dbuchwald/6502/Software/load/22_msbasic/os1_todo.txt

1. (DONE) Remove self-modyfying code
2. (POSTPONED) Remove dependency on custom memory segments
3. (DONE) Add Exit keyword
4. Case-insensitive comparison for tokens
5. (DONE) Disable clear at startup
6. Reduce ZP footprint (optional)
7. (DONE) Correct segment alignment
8. Fix issue with non-page aligned INPUTBUFFER
9. Make INPUTBUFFER allocation by linker
