dbuchwald/6502/(threads)

Thread 2 (2020-03-20):

Add a "ok, now what?" doc section

danecreekphotography, 2020-03-20:
Update the readme.md (or some other doc) with instructions on what to do after all the parts are soldered onto the board to verify things work correctly. Include things like:

1. How to attach the clock to the main board
2. How to use a jumper on the main board to get 1MHz clock
3. Which program to run first (04_blink_s) and second (13_4bit_lcd?)

dbuchwald, 2020-03-26:
This should be now available - can you verify and update the issue accordingly?

danecreekphotography, 2020-03-26:
Yes, this is fixed now!

Closed 2020-03-26.

Thread 3 (2020-03-20):

Add a readme for the firmware folder

danecreekphotography, 2020-03-20:
Add a readme to the firmware folder that explains what each app does, and whether they work with the current board design.

dbuchwald, 2020-04-01:
This one can be closed too, right?

danecreekphotography, 2020-04-01:
Yes!

dbuchwald, 2020-04-07:
Closing then.

Closed 2020-04-07.

Thread 5 (2020-03-20):

Add a "how to use this with Ben's stuff" document

danecreekphotography, 2020-03-20:
I suspect several people will come to this board/project while watching Ben Eater's tutorials on YouTube. The board design has variations from what Ben's doing though so nothing from Ben's tutorials will work directly.

Add documentation that explains the differences between Ben's design and this design, and provide specific steps on how to adapt Ben's code to work on this board:

1. Document the difference in address ranges, perhaps with a helpful graphic to compare the two side-by-side
2. Explain briefly why these changes were made
3. Explain how to update the locations in Ben's sample apps to ones that will work with this board

This documentation is clear enough when I can take Ben's code with updated address locations, assemble it using the assembler he uses, and have it work on this board.

dbuchwald, 2020-03-26:
This should now be covered, let me know if further changes are required

danecreekphotography, 2020-03-26:
Yes, this is fixed!

Closed 2020-03-26.

Thread 6 (2020-03-20):

Replace power on reset logic

danecreekphotography, 2020-03-20:
Instead of using the 555 timer for power on reset, use a DS1813. See https://old.reddit.com/r/beneater/comments/f9oanx/6502_power_on_reset/fitvhyv/

Thread 7 (2020-03-20):

Add a pin 1 indicator for the UART

danecreekphotography, 2020-03-20:
The silk screen on the 6502 board doesn't have an indicator for pin 1/up for the UART SMD. I had to crack open the board design in KiCad to see which one was pin 1 and make sure I put the SMD on the right way.

It'd be nice to have an indicator right on the board for which way the UART goes, just like there are for the larger ICs.

Thread 11 (2020-03-26):

Add support for WDC65C51 ACIA chip in software

dbuchwald, 2020-03-26:
Currently the software is not compatible with WDC65C51 chips due to TX-buffer-empty bug exhibited by these ICs.

dbuchwald, 2020-05-13:
Support for WDC65C51 has been implemented successfully.

Closed 2020-05-13.

Thread 15 (2020-03-26):

Redesign PCB to use smaller footprint SMD components

dbuchwald, 2020-03-26:
The whole circuitry could be largely simplified and the board size reduced if certain components are replaced by SMD counterparts

danecreekphotography, 2020-03-27:
Honestly one of the joys of using your PCB was that it *didn't* use SMD components. For noobs like me who don't have a ton of soldering experience it's way less intimidating to have a board that's all through-hole!

BestDelphini, 2020-07-20:
I learned to solder in high school and then in Navy I had to re-learn as the requirements are much different.
I have a lot solder burns from soldering in very small areas and even upside down. I have not used SMD components and like Dan I am glad there is projects that don't need it. Yes, it is smaller and even less problems with speed. I will give it a chance but don't want to. Doing things that you still understand and can have fun putting it together is what I want.

dbuchwald, 2020-07-20:
While I do understand your point about SMD components (and the fact that they are, essentially, more difficult to work with), there are certain aspects you have to take into account:

Availability of THT/PDIP components - unfortunately, when trying to use more modern chips, your options are very limited. Sometimes you can go with PLCC and THT socket for those, but more frequently than not it's not even an option,
Price factor - PCB can be made significantly smaller, when using SMD components, reducing manufacturing price. The components themselves are cheaper sometimes (not always),
SMT assembly is also significantly easier, cheaper and accessible to home user nowadays. Hot air stations of decent quality are comparable to similar soldering irons, there is plenty of material online on how to use them properly,
Last but not least - there is also my own personal "challenge" factor. I don't like doing the same thing twice the same way, I need to challenge myself, learn and develop new skills. Yes, I was intimidated at first when I saw the size of FT230XS, but I did enjoy the achievement when I managed to solder it on, and I now I have access to variety of chips not available in THT option.

The best, to be honest, would be to create two versions of the board: one that uses SMD components and one that doesn't. After schematic for version 2 is done, the project can be forked or enriched with PR. Let's see where it goes :)

BestDelphini, 2020-07-20:
I will give it a chance and I am sure I will come to the same conclusion. I have been playing with WD's W65C02SXB but was very disappointed. I was looking elsewhere when I found your project and I am willing to give it a go.

Thread 16 (2020-03-26):

Replace PS/2 port by USB connector

dbuchwald, 2020-03-26:
Assuming that the keyboard used would fall back to PS/2 compatibility mode. Will be tested first with simple PS/2->USB homemade adapter.

Thread 18 (2020-03-26):

Document Windows environment toolchain

dbuchwald, 2020-03-26:

danecreekphotography, 2020-03-27:
By far the easiest way to run this on Windows is to... not run it on Windows. Instead use WSL2 + Ubuntu from the Windows Store. Everything will build out of the box once you clone the repo with no messing around trying to get make, assemblers, etc. running on Windows.

For code editing Visual Studio Code's remote tools make it a dream. From within the Ubuntu instance you can just run VS Code and edit, save, whatever.

Flashing the ROM is done using xgpro on the Windows side. Arduino serial monitoring is also done with Arduino IDE on the Windows side.

This is how I've done every bit of building/hacking/editing with this project and it's perfect.

The only piece missing is command-line ability to transfer via xmodem. It's a minor pain, but still better than flashing the ROM every time.

dbuchwald, 2020-03-28:
For me the winning combination is Cygwin + ExtraPuTTy, but I need to document it.

Closed 2020-03-31.

Thread 19 (2020-03-26):

Test drive 8MHz clock

dbuchwald, 2020-03-26:
Currently, due to usage of R6551 chip for ACIA, clock speed is limited to 2MHz, but when WDC65C51 is supported (#11 ), it should be possible to increase up to 14MHz

dbuchwald, 2020-05-13:
Test drive completed successfully, some modifications required to LCD code. This has not been anticipated, so detailed analysis with logic probe is required for conclusive results.

dbuchwald, 2020-06-23:
8MHz operation is now fully supported.

Closed 2020-06-23.

Thread 21 (2020-03-28):

Support other layouts of LCD screen

dbuchwald, 2020-03-28:
Currently 20x4 size is assumed, but it would be great to make all the software to work correctly on 20x2.

Thread 22 (2020-03-28):

Document md5sum on MacOS

dbuchwald, 2020-03-28:
Currently it's failing on MacOS due to lack of md5sum by default - document brew install md5sha1sum

Closed 2020-03-31.

Thread 30 (2020-04-04):

Parse functions should check param length

dbuchwald, 2020-04-04:
Currently parse is successful if there are trailing characters - not correct

dbuchwald, 2020-04-05:
Resolved with latest commit

Closed 2020-04-05.

Thread 32 (2020-04-06):

Verify addresses passed to monitor

dbuchwald, 2020-04-06:
Currently this is possible to pass starting address after end address - to be corrected

Closed 2020-04-06.

Thread 34 (2020-04-07):

Incorrect value for  RV1 in BOM for clock module

Dave-TR3A, 2020-04-07:
The BOM for the clock module lists a value of 10K for RV1 (a Piher PT10-LV10-105 potentiometer).

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

That must be a typo: the Piher part number is actually for a 1M potentiometer.

With a 10K pot, the astable circuit generates a square wave with frequency between 62 and 481 Hz, which may be too fast for troubleshooting. Changing to a 1M pot yields a frequency range of 0.72 to 481 Hz.

dbuchwald, 2020-04-08:
Thanks for spotting it! I have just corrected it, can you check and let me know if it can be closed?

Dave-TR3A, 2020-04-08:
Hi Dawid:

I just looked on GitHub. Unfortunately, I’m not seeing the change you made.

Here is a screen shot from moments ago. It shows that RV1 on the BOM is
unchanged, and also shows the URL, date and time.

By the way, I changed the 10K potentiometer on the clock for a 1 M
potentiometer. Now I’m able to generate square waves with frequencies
ranging from .67Hz to 472 Hz (as measured on my oscilloscope). That’s just
what I was hoping for.

Nice job on the clock PCB!

Stay healthy.

Best wishes,

Dave MacKay

*From:* Dawid Buchwald <notifications@github.com>
*Sent:* April 8, 2020 3:25 AM
*To:* dbuchwald/6502 <6502@noreply.github.com>
*Cc:* Dave MacKay <dave@mdmackay.ca>; Author <author@noreply.github.com>
*Subject:* Re: [dbuchwald/6502] Incorrect value for RV1 in BOM for clock
module (#34)

Thanks for spotting it! I have just corrected it, can you check and let me
know if it can be closed?

—
You are receiving this because you authored the thread.
Reply to this email directly, view it on GitHub
<https://github.com/dbuchwald/6502/issues/34#issuecomment-610796642>, or
unsubscribe
<https://github.com/notifications/unsubscribe-auth/APC67OG7PRJV5STPSMBNMJLRLQREDANCNFSM4MDJ7KFA>
.

Dave-TR3A, 2020-04-08:
And now the change is showing up. Here’s a screenshot showing it:

Well done! Issue closed.

*From:* Dawid Buchwald <notifications@github.com>
*Sent:* April 8, 2020 3:25 AM
*To:* dbuchwald/6502 <6502@noreply.github.com>
*Cc:* Dave MacKay <dave@mdmackay.ca>; Author <author@noreply.github.com>
*Subject:* Re: [dbuchwald/6502] Incorrect value for RV1 in BOM for clock
module (#34)

Thanks for spotting it! I have just corrected it, can you check and let me
know if it can be closed?

—
You are receiving this because you authored the thread.
Reply to this email directly, view it on GitHub
<https://github.com/dbuchwald/6502/issues/34#issuecomment-610796642>, or
unsubscribe
<https://github.com/notifications/unsubscribe-auth/APC67OG7PRJV5STPSMBNMJLRLQREDANCNFSM4MDJ7KFA>
.

Dave-TR3A, 2020-04-08:
Clock module BOM updated to show value of RV1 as 1M ohm.

dbuchwald, 2020-04-08:
Thanks a lot, stay safe!

Closed 2020-04-08.

Thread 36 (2020-04-09):

Prevent LCD routines from altering tmp/ptr variables

dbuchwald, 2020-04-09:
Currently all the code has been changed to work around this, but it can have negative impact on future code maintainability

Closed 2020-04-09.

Thread 37 (2020-04-09):

Enable abort operation in modem receive

dbuchwald, 2020-04-09:
Currently it's not possible to abort receive operation

dbuchwald, 2020-04-18:
Fixed

Closed 2020-04-18.

Thread 38 (2020-04-10):

Add support for capslock key in keyboard controller

dbuchwald, 2020-04-10:
Currently it simply doesn't work - keypress is registered, but apparently it requires command to be sent back to keyboard to enable.
Not that it's high priority defect, but should be fixed.

Thread 39 (2020-04-11):

Add modem receive failure after long wait with no reply

dbuchwald, 2020-04-11:
Currently it waits forever, should fail after several attempts

Thread 40 (2020-04-11):

Add printable characters preview in Monitor get function

dbuchwald, 2020-04-11:
Currently only hex values are displayed, but for printable characters it would be good to print them "as is" as well

dbuchwald, 2020-04-30:
Resolved

Closed 2020-04-30.

Thread 44 (2020-04-18):

Add direct links to purchase BOM items

danecreekphotography, 2020-04-18:
Add links to Jameco and/or DigiKey for purchasing the items on the BOM.

danecreekphotography, 2020-04-18:
Working on this now.

dbuchwald, 2020-05-13:
This should be closed now, right?

danecreekphotography, 2020-05-13:
Yup!

Closed 2020-05-13.

Thread 49 (2020-05-12):

VGA video output

marcpiulachs, 2020-05-12:
Do you plan to add any kind of video output to the computer? You currently have a ATtiny4313 that is only used for the ps/2 keyboard interface that could probably also be used to generate some rudimentary VGA signal https://hackaday.com/2015/12/17/attiny-does-170x240-vga-with-8-colors/

dbuchwald, 2020-05-13:
Hey, thanks for sharing, and yes, I'm aware of the possibility to use ATtiny as VGA signal generator, but there are two issues with it at the moment:

1. Current solution doesn't provide enough video RAM for any reasonable output (keyboard buffer takes up a lot of memory on ATTiny), so I would need to share system RAM between ATTiny and 6502, and while this is perfectly doable, it requires access to certain 6502 pins that are currently "blocked" (as in: pulled up or down on PCB). This basically requires another revision of PCB and this one might actually be used for it:
https://github.com/tonylweil/6502
2. Even if I ever do any kind of VGA interface, I would rather implement that with much simpler and easier to control set of TTL chips, like the Ben's video card. That being said, I don't have that much interest in VGA signal generation, and I definitely don't want to build any kind of primitive game console. What I wanted this thing to be was educational device that demonstrates basics of computer build and OS development. Serial connection is perfectly sufficient for these purposes...

Again - at some point I might actually consider building discrete, TTL based VGA output, but mostly aimed at text mode. Graphics will be always secondary.

Thanks for showing interest in my project!

marcpiulachs, 2020-05-13:
Hi, it makes perfectly sense. Thanks for your great work with this project, it's a great tool for people like me who came from a software background with little experience on hardware that want to learn the basics of a computer and how it works but does not feel confortable with wires and breadboards, also the software is a great complement to Ben's excelent series. Please keep the great work!

dbuchwald, 2020-05-13:
Thanks for your comment; it seems that quite a lot of us share the same background in software development and this might be the first serious EE project. It is definitely the first for me :)

And this is exactly where I envisioned this project - to be soft of "no frills" intro to hardware and low level software design, building on top of Ben's introduction to 6502 and computer prototyping.

kyleeddy, 2021-08-12:
Not VGA, but definitely authentic - I've had some initial luck using the [TMS9918a board](https://github.com/jblang/TMS9918A) designed by [@jblang](https://www.github.com/jblang). Connection uses pins available on the J7 connect of your v001 board. The board is designed to work with the rc2014-style systems, but works well with some creative use of the jumpers and an added 74HCT04 for timing delays.

Alex-Kw, 2023-01-17:
> Not VGA, but definitely authentic - I've had some initial luck using the [TMS9918a board](https://github.com/jblang/TMS9918A) designed by [@jblang](https://www.github.com/jblang). Connection uses pins available on the J7 connect of your v001 board. The board is designed to work with the rc2014-style systems, but works well with some creative use of the jumpers and an added 74HCT04 for timing delays.

If we are mentioning the RC2014, there is an HDMI and Composite Pi terminal, and a VGA terminal. The latter is more relevant here and more available anyway. I have the HDMI one, and it connects to the serial bus; I have TX and RX split so that input comes from a serial device, but output goes to the video terminal. It's likely this could be adapted for many microcomputers with serial text output. https://rc2014.co.uk/modules/pi-pico-vga-terminal/

If I get a chance to try it i will report back, as I intend to obtain one for my RC2014 anyway.

Thread 50 (2020-08-03):

Unable to get ps/2 keyboard input working

jonlorusso, 2020-08-03:
I've flashed my ATTiny4313 with the keyboard_4313 sketch, using an Arduino as ISP:

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

I also flashed the rom with`Software/rom/19_keyboard_test`.

When I boot the computer (with a ps2 keyboard plugged in) the lights briefly flash on the keyboard.

It then shows key `4` as being pressed intermittently, but I am unable to type anything.

I checked my solder joints on the ps/2 connector, and they look ok.

dbuchwald, 2020-08-03:
Hey, thanks for reporting this, but I would need more information about the problem:

1. What kind of keyboard are you using (native PS/2 or via connector),
2. How did you flash the ATTiny4313 (I need details on which pin was connected to which pin on the AVR ISP interface),
3. Are you absolutely sure that the keyboard is working fine?

When I get these details I will repeat the same process (including the ATTiny upload) exactly as you did, but with logic analyser connected to the ATTiny pins to see what happens there. Basically this should work "just like that", I have never seen any issues on my build and I know of other builds where it also worked fine. This might be problem with solder joints on the ATTiny or VIA socket. You can do simple continuity tests on ATTiny pins and respective VIA connectors, but let's start with me repeating your procedure.

jonlorusso, 2020-08-03:
1. What kind of keyboard are you using (native PS/2 or via connector),

PS/2 keyboard

2. How did you flash the ATTiny4313 (I need details on which pin was connected to which pin on the AVR ISP interface),

I used an Arduino UNO as ISP (ArduinoISP sketch).  I then connected the Arduino UNO to the 6502 ICSP interface:

5V -> 5V
GND -> GND
Pin 10 -> RESET
Pin 11 -> MOSI
Pin 12 -> MISO
Pin 13 -> SCK

In the Arduino interface I selected "Arduino as ISP", ATTiny4313 as board/chip, and 8 MHz for speed.

3. Are you absolutely sure that the keyboard is working fine?

To be completely honest, I don't know.  I purchased the keyboard specifically for this purpose, so it's brand new, but obviously could be defective.

Thanks!

jonlorusso, 2020-08-03:
> You can do simple continuity tests on ATTiny pins and respective VIA connectors, but let's start with me repeating your procedure.

For what it's worth, everything appears to be wired up correctly (after continuity tests on all the ATTiny pins).

jonlorusso, 2020-08-03:
One additional piece of information (perhaps useless):

The keyboard lights flash again once (briefly) while the text "Keyboard testing program. is displayed on the LCD, but prior to the "Key pressed: 4" and "Key pressed [ENTER]"

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

dbuchwald, 2020-08-04:
Hey, sorry, I have tried to replicate the issue you are observing, but it still works on my build. These are the steps I took:

1. Checked out master branch
2. Uploaded rom/19_keyboard_test to EEPROM
3. Uploaded keyboard_4313 using Arduino as ISP programmer (the only difference - used Arduino Mega instead of Uno, as I don't own one)
4. Inserted 1MHz oscillator for system clock
5. Connected PS/2 keyboard
6. Run the computer

It detected keyboard correctly and worked fine displaying keys that I pressed.

So, current version of the code should work correctly with the PCB and working keyboard. These are the possible issues that could cause it:

- Incorrect seating of ATTiny4313 or VIA chip
- Failed upload (I actually had to struggle for a bit to upload the sketch, it didn't work immediately, USBasp is much more stable)
- Soldering issue
- Broken keyboard
- Last but not least - I don't even know if this is possible, but maybe the PS/2 connector you use doesn't match the pinout assumed in PCB design?

I would advise using one of these cheap logic analysers (13$ or so) to confirm that the signal coming to ATTiny is correct. You need to connect two lines to pins 2 and 6 - these are DAT/CLK of PS/2 respectively. If this is correct (represents keys pressed on keyboard), then check ATTiny output on pins 12-19 to confirm that correct data is transmitted to VIA.

Sorry I can't help you any further, but it "just works" on my build...

dbuchwald, 2020-08-05:
One last thing - it's actually possible that the fuses on your ATTiny are incorrectly set. Arduino IDE doesn't burn them with the sketch, you need to "Burn Bootloader" first, even if you don't intend to use the bootloader (which, by the way, is not even possible for ATTiny4313). Try this and let me know if it helps, please.

jonlorusso, 2020-08-05:
> you need to "Burn Bootloader" first, even if you don't intend to use the bootloader

🤦‍♂️🤦‍♂️🤦‍♂️

That was it!  Keyboard is now working! Thanks!

dbuchwald, 2020-08-05:
Awesome, I'm glad we managed to find the reason! I will update the documentation to reflect this step.

dbuchwald, 2020-08-05:
Documentation updated

Closed 2020-08-05.

Thread 51 (2020-09-27):

Please provide PDFs for schematic

marcin-chwedczuk, 2020-09-27:
Currently you cannot take a look at the schematic using build-in GitHub file preview.
Could you add schematics in PDF format, please? (can be done using File -> Plot... in KiCad).

Schematics would also be much easier to read if they where stored into a single directory as a hierarchical sheet. Then you can have one PDF with hierarchy on the first page and all the schematics on the following pages.

marcin-chwedczuk, 2020-09-28:
Ouch - I didn't notice them. Yeah they are there not that you pointed it out. Thanks.

Closed 2020-09-28.

Thread 53 (2021-08-23):

help compiling .c files

mattmi91, 2021-08-23:
I am unsure how to compile the .c files in the 6502 projects ROM folder im not sure what to use crygwin? cc65? and what commands do I type into these to compile the .C file into an .out file ive been looking on the internet for days and cannot find anything Im looking for so some pointers on how to do this would be nice :)

rprouse, 2021-08-23:
Every project has a `Makefile`, so running `make clean all` should do it for you. It does use cc65, so that needs to be in your path as does GNU Make. I found that Dawid's makefiles don't work well under Windows, so he uses Cygwin.

Instructions to get setup are here, https://github.com/dbuchwald/6502/blob/master/Software/README.md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

mattmi91, 2021-08-23:
I have tried using cygwin and I did install all the packages he said too but not sure what to type to make the .out file? he doesnt how other then just basics on what to do when you first install it which I already did but what do I type in the terminal something like g++ lcdtest.c? tried this and got like 50 errors

rprouse, 2021-08-23:
Did you try typing `make clean all`?

mattmi91, 2021-08-23:
I get this when I type that make: *** No rule to make target 'clean'.  Stop.

mattmi91, 2021-08-23:
ok so I fixed the make file issue but when I do g++ 4bitlcd.s
$ g++ 4bitlcd.s
4bitlcd.s: Assembler messages:
4bitlcd.s: Warning: end of file not at end of a line; newline inserted
4bitlcd.s:1: Error: unknown pseudo-op: `.setcpu'
4bitlcd.s:2: Error: can't open lcd.inc for reading: No such file or directory
4bitlcd.s:3: Error: unknown pseudo-op: `.segment'
4bitlcd.s:9: Error: unknown pseudo-op: `.code'
4bitlcd.s:12: Error: no such instruction: `jsr _lcd_init'
4bitlcd.s:14: Error: no such instruction: `write_lcd '
4bitlcd.s:16: Error: no such instruction: `ldx '
4bitlcd.s:18: Error: no such instruction: `lda chars_msg,x'
4bitlcd.s:19: Error: no such instruction: `beq end_loop'
4bitlcd.s:20: Error: no such instruction: `jsr _lcd_print_char'
4bitlcd.s:21: Error: no such instruction: `inx '
4bitlcd.s:22: Error: no such instruction: `bra char_loop'
4bitlcd.s:24: Error: no such instruction: `bra end_loop'
4bitlcd.s:26: Error: unknown pseudo-op: `.segment'

rprouse, 2021-08-24:
`make` builds all the files, you don't call `g++`. The file that you are trying to compile is assembly language, not C++, so it is assembled by `cc65`, but you don't have to call that either, `make all` does that for you and puts the output in a build or bin folder.

Just switch to the `Software` directory and type `make clean all`. That's it, nothing more, it will build everything.

rprouse, 2021-08-24:
I should add that you can't build most of the individual files in this repo and get a runnable program. Almost all of them include files in the `common` directory, that is why you need the `Makefile`, to coordinate the building and linking of all the files.

mattmi91, 2021-08-24:
so im in the directory of where that c file is and when I type make all I get already a directory message

mattmi91, 2021-08-24:
im just trying to get the a.out file from these so I can program it into my eeprom

rprouse, 2021-08-24:
As I said,

> Just switch to the Software directory and type make clean all. That's it, nothing more, it will build everything.

Then look in the `build` folder that is created.

mattmi91, 2021-08-24:
did what you said and here is the error that I got
$ make clean all
rm -rf build
make -C rom/01_nop_fill ADDRESS_MODE=ext all
make[1]: Entering directory '/home/matthew/6502-master/software/rom/01_nop_fill'
ca65 --cpu 65C02 -Dclock_mode_flag=2  -Dacia_tx_irq=0  -Ddb6502 -I ../../common/include -o ../../build/common/zeropage.o -l ../../build/common/zeropage.lst ../../common/source/zeropage.s
make[1]: ca65: No such file or directory
make[1]: *** [../../common/makefile:184: ../../build/common/zeropage.o] Error 127
make[1]: Leaving directory '/home/matthew/6502-master/software/rom/01_nop_fill'
make: *** [makefile:76: build/rom/01_nop_fill.ext.bin] Error 2

mattmi91, 2021-08-24:
tried under the first clean all test he mentions in the rom folder
$ make clean all
rm -f ../../build/rom/*.bin \
rm -f ../../build/rom/*.raw \
../../build/rom/01_nop_fill/*.o \
../../build/rom/01_nop_fill/*.lst \
../../build/rom/01_nop_fill/*.s \
../../build/rom/01_nop_fill/*.map \
../../build/common/*.o \
../../build/common/*.lst \
../../build/common/*.s \
../../build/lib/*.lib
ca65 --cpu 65C02 -Dclock_mode_flag=2  -Dacia_tx_irq=0  -Ddb6502 -I ../../common/include -o ../../build/common/zeropage.o -l ../../build/common/zeropage.lst ../../common/source/zeropage.s
make: ca65: No such file or directory
make: *** [../../common/makefile:184: ../../build/common/zeropage.o] Error 127

rprouse, 2021-08-24:
1. `make clean` fails if you have not built before and the build directory does not exist. In that case `make all` will do.
2. To solve your error `ca65` needs to be added to your path. Google how to do that in Cygwin, I think you add it to your `.bashrc` file but I don't use Cygwin. If you can type `ca65` at the command line without errors, then `make` will work.

mattmi91, 2021-08-24:
tried adding the path in my system variables
C:\cygwin64\home\matthew\6502-master\Software\ca65
of course did not work -_- this is why I hate dealing with software so irritating lol

rprouse, 2021-08-24:
If you are using cygwin, that isn't a correct Linux path. Try `~/home/matthew/6502-master/Software/ca65`

mattmi91, 2021-08-24:
im using cygwin on windows 10

mattmi91, 2021-08-24:
ok I solved the problem but im not getting a bin file that I need like he describes
$ make clean all
rm -f ../../build/rom/*.bin \
rm -f ../../build/rom/*.raw \
../../build/rom/01_nop_fill/*.o \
../../build/rom/01_nop_fill/*.lst \
../../build/rom/01_nop_fill/*.s \
../../build/rom/01_nop_fill/*.map \
../../build/common/*.o \
../../build/common/*.lst \
../../build/common/*.s \
../../build/lib/*.lib
ca65 --cpu 65C02 -Dclock_mode_flag=2  -Dacia_tx_irq=0  -Ddb6502 -I ../../common/include -o ../../build/common/zeropage.o -l ../../build/common/zeropage.lst ../../common/source/zeropage.s
ca65 --cpu 65C02 -Dclock_mode_flag=2  -Dacia_tx_irq=0  -Ddb6502 -I ../../common/include -o ../../build/common/sysram_map.o -l ../../build/common/sysram_map.lst ../../common/source/sysram_map.s
ca65 --cpu 65C02 -Dclock_mode_flag=2  -Dacia_tx_irq=0  -Ddb6502 -I ../../common/include -o ../../build/rom/01_nop_fill/nop_fill.o -l ../../build/rom/01_nop_fill/nop_fill.lst nop_fill.s
ca65 --cpu 65C02 -Dclock_mode_flag=2  -Dacia_tx_irq=0  -Ddb6502 -I ../../common/include -o ../../build/common/syscalls.o -l ../../build/common/syscalls.lst ../../common/source/syscalls.s
ca65 --cpu 65C02 -Dclock_mode_flag=2  -Dacia_tx_irq=0  -Ddb6502 -I ../../common/include -o ../../build/common/acia.o -l ../../build/common/acia.lst ../../common/source/acia.s
ca65 --cpu 65C02 -Dclock_mode_flag=2  -Dacia_tx_irq=0  -Ddb6502 -I ../../common/include -o ../../build/common/blink.o -l ../../build/common/blink.lst ../../common/source/blink.s
ca65 --cpu 65C02 -Dclock_mode_flag=2  -Dacia_tx_irq=0  -Ddb6502 -I ../../common/include -o ../../build/common/core.o -l ../../build/common/core.lst ../../common/source/core.s
ca65 --cpu 65C02 -Dclock_mode_flag=2  -Dacia_tx_irq=0  -Ddb6502 -I ../../common/include -o ../../build/common/keyboard.o -l ../../build/common/keyboard.lst ../../common/source/keyboard.s
ca65 --cpu 65C02 -Dclock_mode_flag=2  -Dacia_tx_irq=0  -Ddb6502 -I ../../common/include -o ../../build/common/lcd.o -l ../../build/common/lcd.lst ../../common/source/lcd.s
ca65 --cpu 65C02 -Dclock_mode_flag=2  -Dacia_tx_irq=0  -Ddb6502 -I ../../common/include -o ../../build/common/lcd4bit.o -l ../../build/common/lcd4bit.lst ../../common/source/lcd4bit.s
ca65 --cpu 65C02 -Dclock_mode_flag=2  -Dacia_tx_irq=0  -Ddb6502 -I ../../common/include -o ../../build/common/modem.o -l ../../build/common/modem.lst ../../common/source/modem.s
ca65 --cpu 65C02 -Dclock_mode_flag=2  -Dacia_tx_irq=0  -Ddb6502 -I ../../common/include -o ../../build/common/string.o -l ../../build/common/string.lst ../../common/source/string.s
ca65 --cpu 65C02 -Dclock_mode_flag=2  -Dacia_tx_irq=0  -Ddb6502 -I ../../common/include -o ../../build/common/utils.o -l ../../build/common/utils.lst ../../common/source/utils.s
ca65 --cpu 65C02 -Dclock_mode_flag=2  -Dacia_tx_irq=0  -Ddb6502 -I ../../common/include -o ../../build/common/via.o -l ../../build/common/via.lst ../../common/source/via.s
ca65 --cpu 65C02 -Dclock_mode_flag=2  -Dacia_tx_irq=0  -Ddb6502 -I ../../common/include -o ../../build/common/via_utils.o -l ../../build/common/via_utils.lst ../../common/source/via_utils.s
ca65 --cpu 65C02 -Dclock_mode_flag=2  -Dacia_tx_irq=0  -Ddb6502 -I ../../common/include -o ../../build/common/tty.o -l ../../build/common/tty.lst ../../common/source/tty.s
ca65 --cpu 65C02 -Dclock_mode_flag=2  -Dacia_tx_irq=0  -Ddb6502 -I ../../common/include -o ../../build/common/parse.o -l ../../build/common/parse.lst ../../common/source/parse.s
ca65 --cpu 65C02 -Dclock_mode_flag=2  -Dacia_tx_irq=0  -Ddb6502 -I ../../common/include -o ../../build/common/menu.o -l ../../build/common/menu.lst ../../common/source/menu.s
ar65 r ../../build/lib/common.lib ../../build/common/syscalls.o ../../build/common/acia.o ../../build/common/blink.o ../../build/common/core.o ../../build/common/keyboard.o ../../build/common/lcd.o ../../build/common/lcd4bit.o ../../build/common/modem.o ../../build/common/string.o ../../build/common/utils.o ../../build/common/via.o ../../build/common/via_utils.o ../../build/common/tty.o ../../build/common/parse.o ../../build/common/menu.o
ca65 --cpu 65C02 -Dclock_mode_flag=2  -Dacia_tx_irq=0  -Ddb6502 -I ../../common/include -o ../../build/common/crt0.o -l ../../build/common/crt0.lst ../../common/source/crt0.s
cp -f ../../common/none.lib ../../build/lib/common.c.lib
ar65 r ../../build/lib/common.c.lib ../../build/common/crt0.o
ld65  -C ../../common/firmware.ext.cfg -m ../../build/rom/01_nop_fill/01_nop_fill.ext.map -o ../../build/rom/01_nop_fill.ext.bin ../../build/common/zeropage.o ../../build/common/sysram_map.o ../../build/rom/01_nop_fill/nop_fill.o ../../build/lib/common.lib ../../build/lib/common.c.lib

rprouse, 2021-08-24:
did you look in the folders under build/roms? I saw them being created in the output you sent.

mattmi91, 2021-08-24:
thanks for the help with the advice of getting that make clean all command, the fix was I had to put cc65 exe files inside the cygwin64 folder then it worked it was a lucky guess but I got it :)

rprouse, 2021-08-24:
Excellent, happy 8-bit computing. Can you close this issue? Only you or @dbuchwald can.

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

mattmi91, 2021-08-24:
maybe it would help someone else that has similar problem?

rprouse, 2021-08-24:
It may help someone else, but they will still be able to find it in search. It is normal in GitHub to close issues that are resolved or the questions answered.

Thread 56 (2022-07-15):

Dead?

Phunter1, 2022-07-15:
Seems everything dropped off 2 years ago. Is this project dead? I would rather not put time into something that is dead.

Kevin-smurf, 2022-07-15:
Hi Phunter1,  I built dbuchwald's project a couple of years ago, after watching Ben Eaters excellent tutorials on YouTube.
I firstly built Bens 6502 breadboard project after sourcing all the components myself.
Then I found Mr Buchwald's PCB version, and built that too.  I'm not a programming buff, so got a bit lost, but finally got it working.  I learnt heaps from doing this.
It's been on the "back burner" since then !!!

dbuchwald, 2022-07-15:
Hey, the project is not dead, but indeed, it has been hibernating for last two years. I started redesign of the board, but scope creep and too ambitious goals prevented me from reaching next milestone. Seeing how it blocked my progress I went back to drawing board, decided to split the project in smaller chunks and one of the prerequisites was using latest line of AVR microprocessors with different programming interface.
Long story short, I went to implement the new interface in avrdude project and spent there next six months. Changed jobs in the meantime and, well, life simply happened. The fact that there are other better designs out there doesn't help either, but the main reason for putting that aside was simply lack of interest from the community. Most of these projects end up like that, because we learn from each other and the most persistent prevail. People would rather design their own build, and use others as an inspiration/guideline.

As for putting time into something that is dead, I'm not entirely sure you mean. The PCB has been built by many people, and as far as I know, each of these builds is running fine. Software is usable, and there is enough of it to use it to start building your own applications. So yeah, it's not like you will spend weeks building it and figuring out compilation options - it will simply build, load and run, and if you use PCB you are almost guaranteed to have the thing running in a week.
If you have any issues, you can always contact me here or drop me an e-mail.

Phunter1, 2022-07-15:
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

This is the first time I've gotten into projects like this so I may be looking at it in the wrong light.

Nice to know it's not forgotten.

I'll be building this project shortly.

Closed 2022-07-15.

Thread 58 (2025-01-03):

replacement for  FB1 Ferrite bead small

bobhillierca, 2025-01-03:
I can't locate a source for FB1 small Ferrite bead.  Digikey shows them no longer available and I can't find them on the Jameco site.  I have tried to puzzle through the characteristics to select an equivalent but have ended up ordering two unsuitable components. Can someone recommend an alternative component that can fit and/or barnacle to the pcb?

rprouse, 2025-01-06:
I had trouble sourcing one too. I used this and haven't had an issue, https://www.digikey.ca/en/products/detail/toshiba-semiconductor-and-storage/LB4X2X8U/4701156
