dbuchwald/6502/Schematics/65C02_Computer/65C02_Computer.pdf

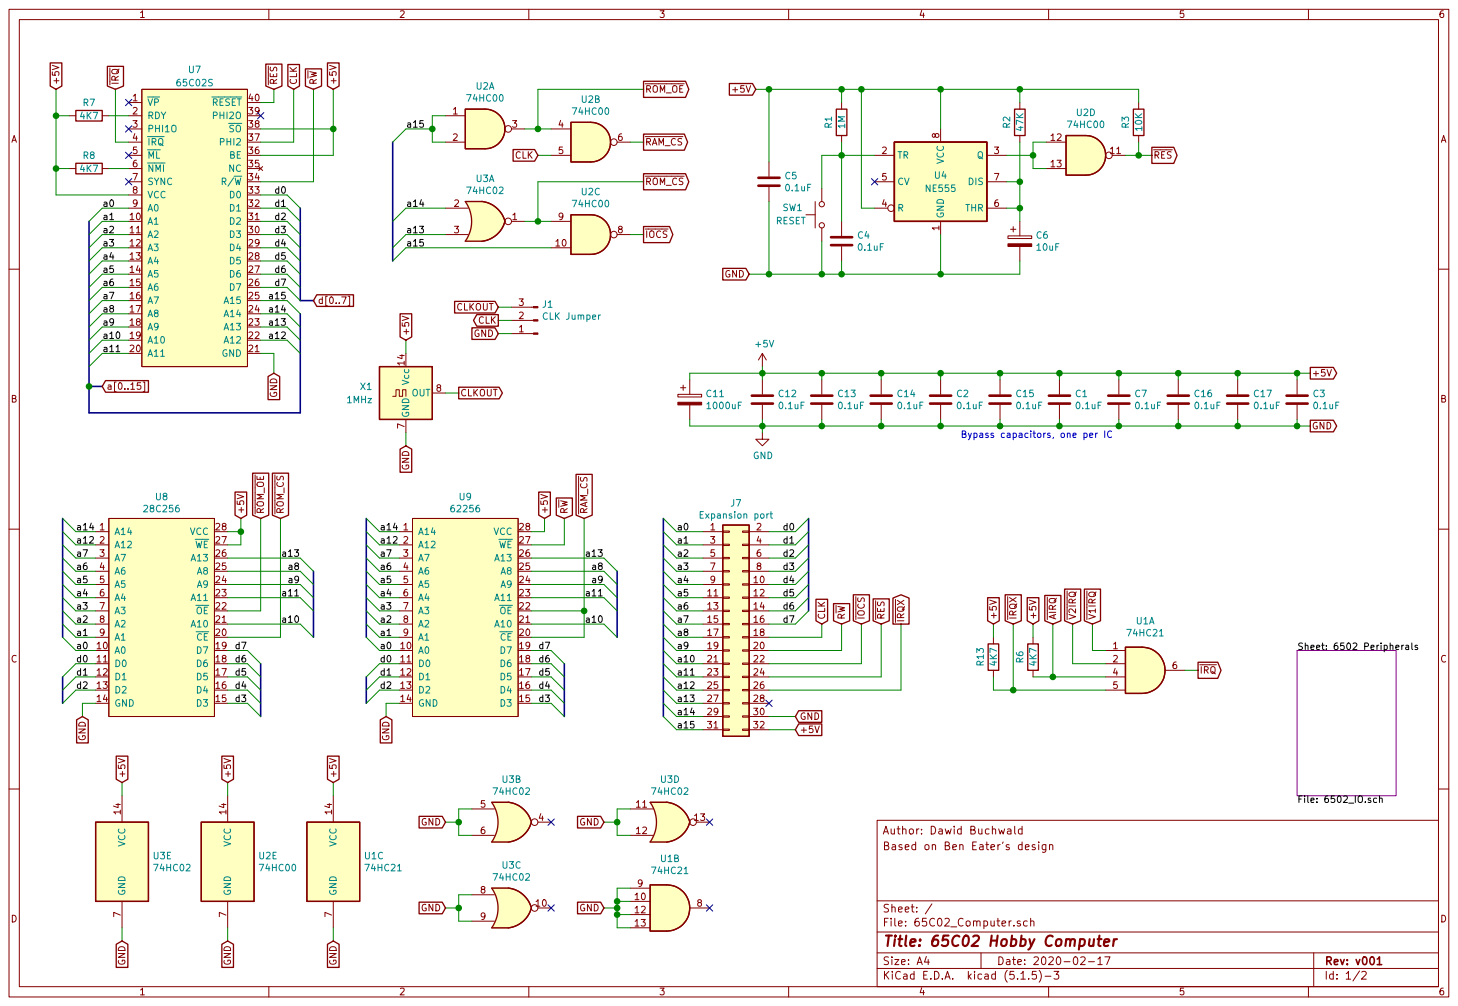
[picture p1: page 1]

Id: 1/2 Title: 65C02 Hobby Computer

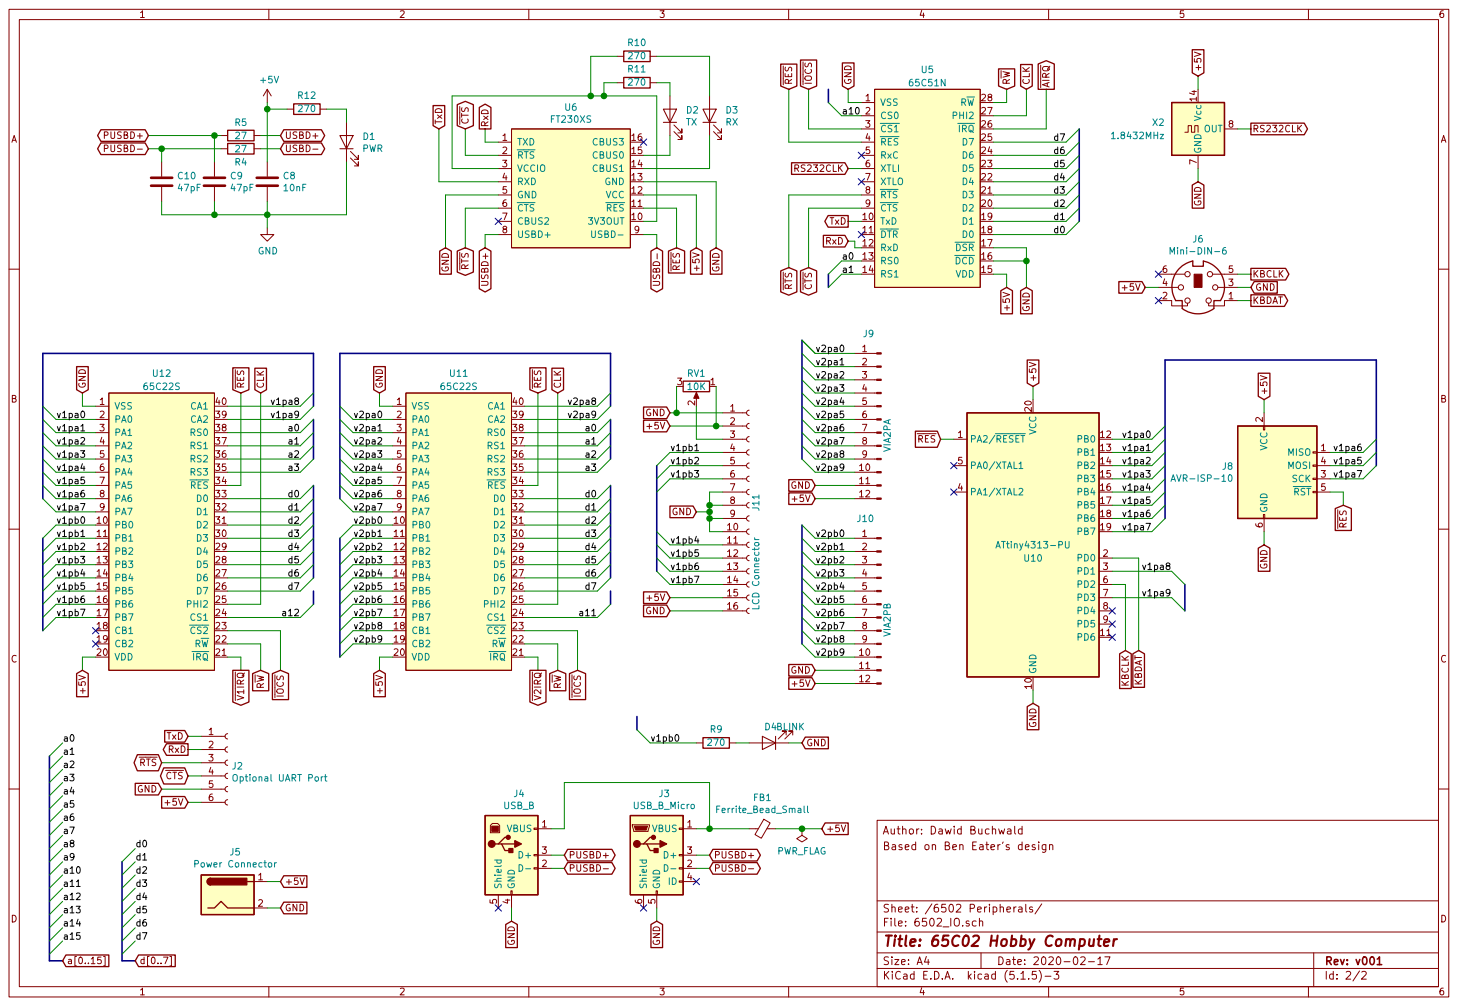
[picture p2: page 2]

2 SCK 3 MOSI 4 RST 5 GND

Based on Ben Eater's design Author: Dawid Buchwald

Sheet: /6502 Peripherals/
File: 6502_IO.sch
Id: 2/2 Title: 65C02 Hobby Computer
