dbuchwald/6502/Schematics/Clock_module/Clock_module.pdf

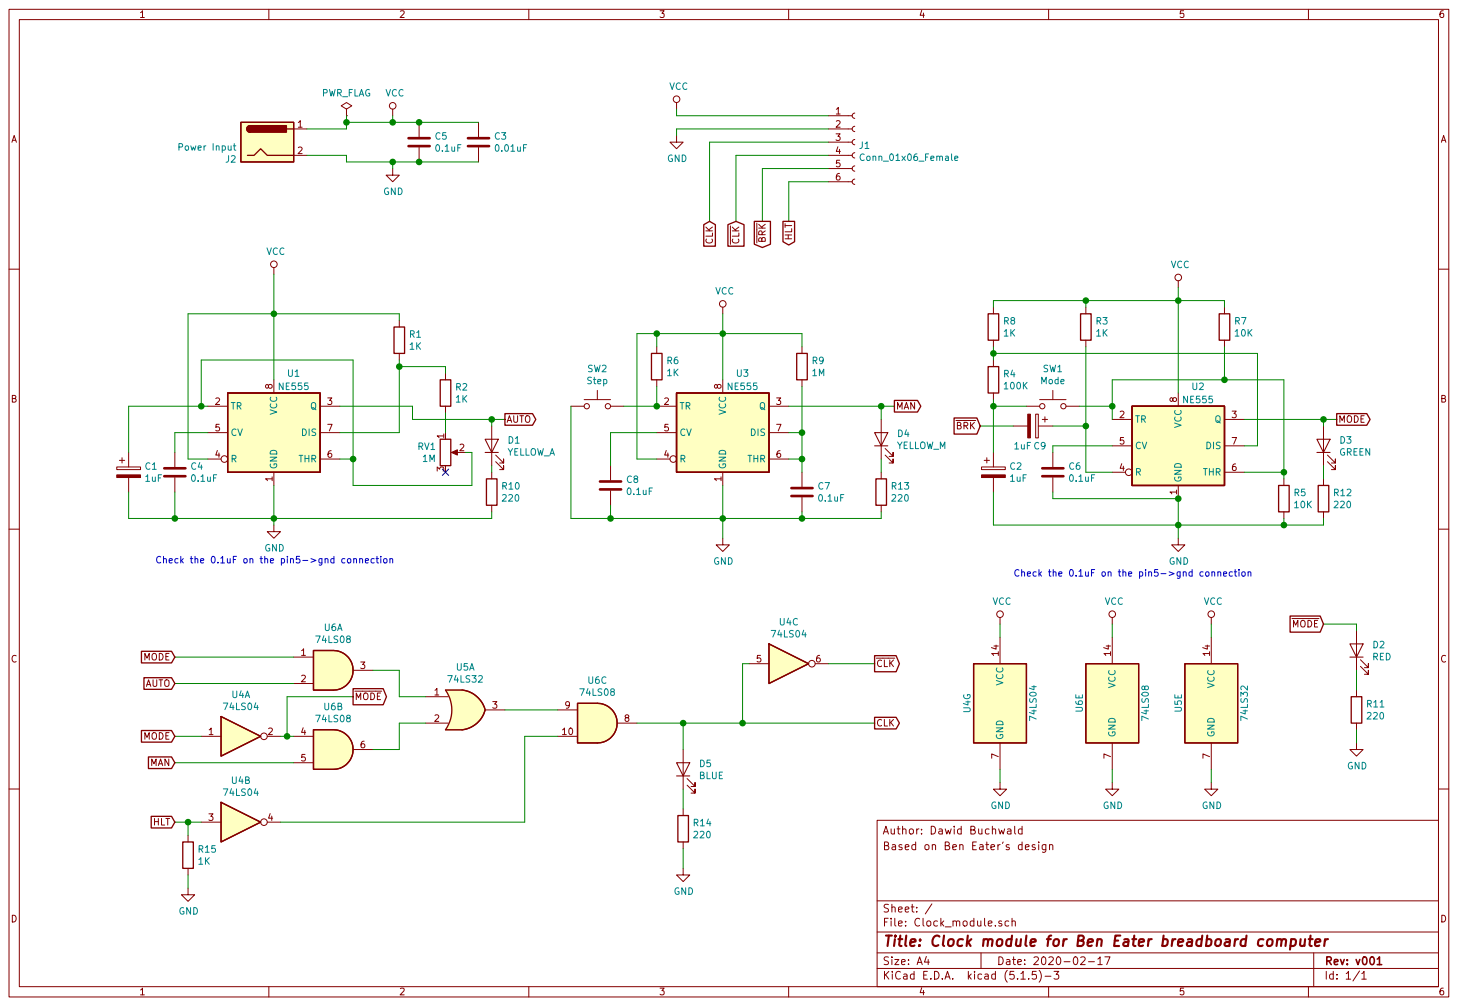
[picture p3: page 1]

File: Clock_module.sch Sheet: / Based on Ben Eater's design Author: Dawid Buchwald GND

Check the 0.1uF on the pin5->gnd connection

7 U5E 74LS32 VCC VCC VCC GND GND GND GND

Id: 1/1 Title: Clock module for Ben Eater breadboard computer
