dbuchwald/6502/Schematics/DB6502_v002/DB6502_v002.kicad_pcb

## KiCad design LightModulator.sch

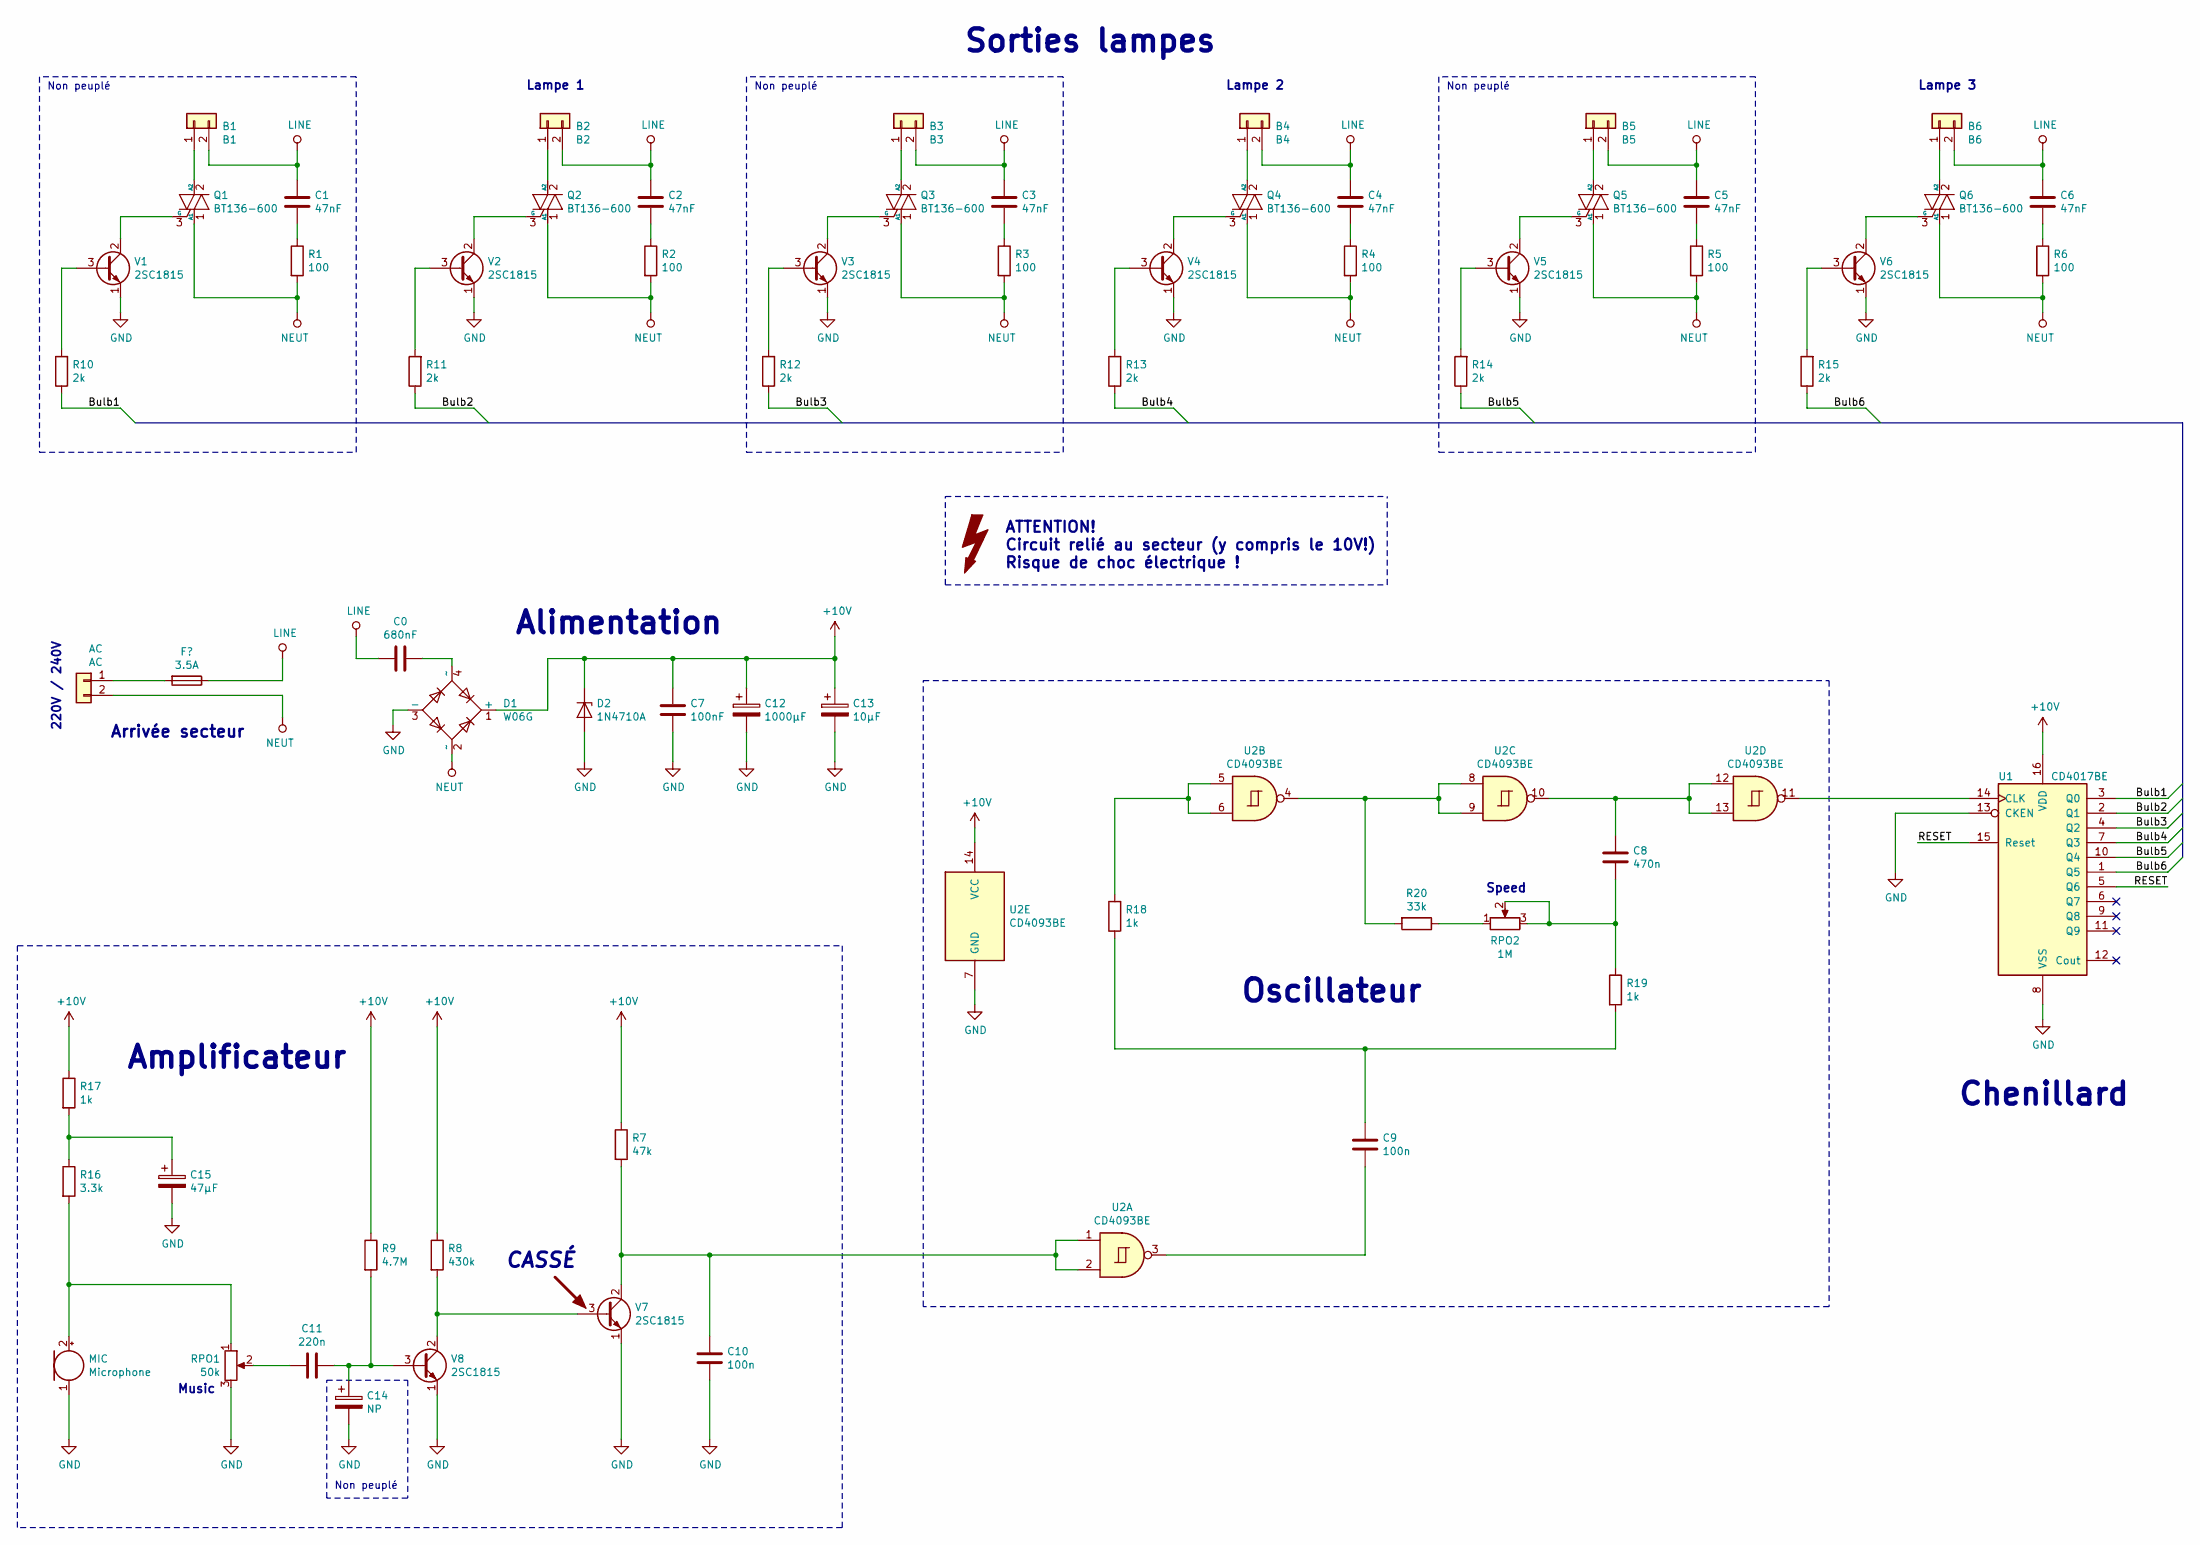
[picture p4: schematic LightModulator.sch]

Parts:
AC: AC
B1: B1
B2: B2
B3: B3
B4: B4
B5: B5
B6: B6
C0: 680nF
C1, C2, C3, C4, C5, C6: 47nF
C7: 100nF
C8: 470n
C9, C10: 100n
C11: 220n
C12: 1000µF
C13: 10µF
C14: NP
C15: 47µF
D1: W06G; Diode_Bridge_Round_D9.8mm
D2: 1N4710A; D_DO-41_SOD81_P10.16mm_Horizontal
MIC: Microphone
Q1, Q2, Q3, Q4, Q5, Q6: BT136-600; TO-220-3_Vertical
R1, R2, R3, R4, R5, R6: 100
R7: 47k
R8: 430k
R9: 4.7M
R10, R11, R12, R13, R14, R15: 2k
R16: 3.3k
R17, R18, R19: 1k
R20: 33k
RPO1: 50k
RPO2: 1M
U1: CD4017BE; DIP-16_W7.62mm
U2: CD4093BE; DIP-14_W7.62mm
V1, V2, V3, V4, V5, V6, V7, V8: 2SC1815; TO-92_Inline

Connections:
+10V: C7.1, C12.1, C13.1, D1.1 (+), D2.1 (K), R7.1, R8.1, R9.1, R17.1, U1.16 (VDD), U2.14 (VCC)
Bulb1: R10.1, U1.3 (Q0)
Bulb2: R11.1, U1.2 (Q1)
Bulb3: R12.1, U1.4 (Q2)
Bulb4: R13.1, U1.7 (Q3)
Bulb5: R14.1, U1.10 (Q4)
Bulb6: R15.1, U1.1 (Q5)
GND: C7.2, C10.1, C12.2, C13.2, C14.2, C15.2, D1.3 (-), D2.2 (A), MIC.1 (-), RPO1.3, U1.8 (VSS), U1.13 (CKEN), U2.7 (GND), V1.1 (E), V2.1 (E), V3.1 (E), V4.1 (E), V5.1 (E), V6.1 (E), V7.1 (E), V8.1 (E)
LINE: B1.2, B2.2, B3.2, B4.2, B5.2, B6.2, C0.2, C1.1, C2.1, C3.1, C4.1, C5.1, C6.1
NEUT: AC.2, D1.2 (~~), Q1.1 (A1), Q2.1 (A1), Q3.1 (A1), Q4.1 (A1), Q5.1 (A1), Q6.1 (A1), R1.2, R2.2, R3.2, R4.2, R5.2, R6.2
unnamed: B1.1, Q1.2 (A2)
unnamed: B2.1, Q2.2 (A2)
unnamed: B3.1, Q3.2 (A2)
unnamed: B4.1, Q4.2 (A2)
unnamed: B5.1, Q5.2 (A2)
unnamed: B6.1, Q6.2 (A2)
unnamed: C0.1, D1.4 (~~)
unnamed: C1.2, R1.1
unnamed: C2.2, R2.1
unnamed: C3.2, R3.1
unnamed: C4.2, R4.1
unnamed: C5.2, R5.1
unnamed: C6.2, R6.1
unnamed: C8.1, U2.10, U2.12, U2.13
unnamed: C8.2, R19.1, RPO2.2, RPO2.3
unnamed: C9.1, U2.3
unnamed: C9.2, R18.1, R19.2
unnamed: C10.2, R7.2, U2.1, U2.2, V7.2 (C)
unnamed: C11.1, C14.1, R9.2, V8.3 (B)
unnamed: C11.2, RPO1.2
unnamed: C15.1, R16.1, R17.2
unnamed: MIC.2 (+), R16.2, RPO1.1
unnamed: Q1.3 (G), V1.2 (C)
unnamed: Q2.3 (G), V2.2 (C)
unnamed: Q3.3 (G), V3.2 (C)
unnamed: Q4.3 (G), V4.2 (C)
unnamed: Q5.3 (G), V5.2 (C)
unnamed: Q6.3 (G), V6.2 (C)
unnamed: R8.2, V7.3 (B), V8.2 (C)
unnamed: R10.2, V1.3 (B)
unnamed: R11.2, V2.3 (B)
unnamed: R12.2, V3.3 (B)
unnamed: R13.2, V4.3 (B)
unnamed: R14.2, V5.3 (B)
unnamed: R15.2, V6.3 (B)
unnamed: R18.2, U2.5, U2.6
unnamed: R20.1, RPO2.1
unnamed: R20.2, U2.4, U2.8, U2.9
unnamed: U1.14 (CLK), U2.11
RESET: U1.5 (Q6), U1.15 (Reset)

Notes on the sheet:
Music
Speed
Non peuplé
Lampe 1
Lampe 2
Lampe 3
220V / 240V
CASSÉ
Alimentation
Arrivée secteur
Amplificateur
Oscillateur
Chenillard
ATTENTION! Circuit relié au secteur (y compris le 10V!) Risque de choc électrique !
Sorties lampes
