dbuchwald/6502/AVR/programmer-atmega644/main.c

#include <stdio.h>
#include <avr/io.h>
#include <avr/interrupt.h>
#include "main.h"
#include "uart.h"
#include "28c256.h"
#include "pinout.h"
#include "shell.h"

#define TIMER1_COUNTER 15625 // at 20MHz and 64 prescaler should give 20ms

static uint8_t control_register;
static uint32_t system_timer;

FILE uart_output = FDEV_SETUP_STREAM(uart_putchar, NULL, _FDEV_SETUP_WRITE);
FILE uart_input = FDEV_SETUP_STREAM(NULL, uart_getchar, _FDEV_SETUP_READ);

int main(void)
{
  initSystem();

  return 0;
}

void initSystem(void) {
  // init data direction registers
  // shift register is all output
  CONTROL_DDR  |= (SR_DAT | SR_CLK | SR_OUT);
  // master clock, rw and sync all input
  CONTROL_DDR  &= ~(CLK_BIT | RW_BIT | SYNC_BIT);
  // enable pull-ups on input bits
  CONTROL_POUT |= (CLK_BIT | RW_BIT | SYNC_BIT);
  // address and data buses are all input
  ADDRMSB_DDR  = ALL_INPUT;
  ADDRLSB_DDR  = ALL_INPUT;
  DATA_DDR     = ALL_INPUT;
  // enable pull-ups on inputs
  ADDRMSB_POUT = ALL_PULL_UP;
  ADDRLSB_POUT = ALL_PULL_UP;
  DATA_POUT    = ALL_PULL_UP;

  // shift out default state of control register
  control_register = 0x00;
  updateControlRegister();

  // init timer
  initTimer();

  // init serial interface
  uart_init();

  // redirect standard output
  stdout = &uart_output;
  stdin = &uart_input;

  // enable interrupts
  sei();

  runShell();
}

void initTimer(void) {
  // initialize system timer variable
  system_timer = 0;
  // use x64 prescaler for Timer 1
  TCCR1B = _BV(CS11) | _BV(CS10) | _BV(WGM12);
  // set duration
  OCR1A = TIMER1_COUNTER;
  // initialize
  TCNT1 = 0;
  // clear overflow flag
  TIFR1 = _BV(OCF1A);
  // enable overflow interrupt
  TIMSK1 = _BV(OCIE1A);
}

void assumeBusControl(void) {
  // start by stopping clock and 
  control_register |= CLKSEL_BIT | BE_BIT | RDY_BIT;
  updateControlRegister();
  // master clock and rw are output now
  CONTROL_DDR  |= (CLK_BIT | RW_BIT);
  // lower the clock, we will raise it only when needed
  CONTROL_POUT &= ~CLK_BIT;
  // address and data buses are all output
  ADDRMSB_DDR  = ALL_OUTPUT;
  ADDRLSB_DDR  = ALL_OUTPUT;
  DATA_DDR     = ALL_INPUT;
  // enable pull-up on DATA
  DATA_POUT    = ALL_PULL_UP;
}

void returnBusControl(void) {
  // master clock, rw and sync all input
  CONTROL_DDR  &= ~(CLK_BIT | RW_BIT);
  // enable pull-ups on input bits
  CONTROL_POUT |= (CLK_BIT | RW_BIT);
  // address and data buses are all input
  ADDRMSB_DDR  = ALL_INPUT;
  ADDRLSB_DDR  = ALL_INPUT;
  DATA_DDR     = ALL_INPUT;
  // enable pull-ups on inputs
  ADDRMSB_POUT = ALL_PULL_UP;
  ADDRLSB_POUT = ALL_PULL_UP;
  DATA_POUT    = ALL_PULL_UP;
  // restore clock, BE and RDY operation
  control_register &= ~(CLKSEL_BIT | BE_BIT | RDY_BIT);
  updateControlRegister();
}

void updateControlRegister(void) {
  // shift out current state
  uint8_t temp_shift_out=control_register;
  // disable latch and lower clock line
  CONTROL_POUT &= ~(SR_OUT | SR_CLK);
  // loop over bits
  for (uint8_t idx=0; idx<8; idx++) {
    // shift out most significant bit first
    if (temp_shift_out & 0x80) {
      CONTROL_POUT |= SR_DAT; 
    } else {
      CONTROL_POUT &= ~SR_DAT;
    }
    // pulse clock
    CONTROL_POUT |= SR_CLK;
    CONTROL_POUT &= ~SR_CLK;
    // shift left temp value
    temp_shift_out = temp_shift_out << 1;
  }
  // pulse latch 
  CONTROL_POUT |= SR_OUT;
  // TODO: Might need delay
  //delay(1);
  CONTROL_POUT &= ~SR_OUT;
  // TODO: Might need delay
  //delay(1);
}

ISR (TIMER1_COMPA_vect)
{
  system_timer++;
}

uint32_t getSystemTime(void) {
  uint32_t result;
  cli();
  result = system_timer;
  sei();
  return result;
}
