dbuchwald/6502/(commit log)

2019-12-30 Added Arduino sketches and KiCAD schematics
    [555_troubleshoot.kicad_pcb, 555_troubleshoot.sch]
2019-12-30 Added schematic for basic address decoder
    [Address_decoder_basic.kicad_pcb, Address_decoder_basic.sch]
2020-01-01 Added second version of address decode logic for 32K RAM and 16K ROM
    [Address_decoder_basic_v2.kicad_pcb, Address_decoder_basic_v2.sch]
2020-01-01 Updated v2 decoder schematic
    [Address_decoder_basic_v2.sch]
2020-01-02 Added schematic for extended address decoder
    [Address_decoder_extended.kicad_pcb, Address_decoder_extended.sch]
2020-01-06 Started work on the complete system schematic
    [65C02_Computer.kicad_pcb, 65C02_Computer.sch]
2020-01-07 Added VIA chips to schematic
    [65C02_Computer.sch]
2020-01-07 Added two oscillators
    [65C02_Computer.sch]
2020-01-07 Added ACIA chip
    [65C02_Computer.sch]
2020-01-08 Added RAM and ROM modules to schematic
    [65C02_Computer.sch]
2020-01-08 Added footprints to components
    [65C02_Computer.sch]
2020-01-08 Added automatic RESET on power-on
    [65C02_Computer.sch]
2020-01-14 Fixed issue with Bus Enable connection, replaced inverter by NAND
    [65C02_Computer.sch]
2020-01-16 Small changes to glue logic
    [65C02_Computer.sch]
2020-01-17 Added IRQ connections
    [65C02_Computer.sch]
2020-01-20 Added bypass caps, moved things around
    [65C02_Computer.sch]
2020-01-20 Fixed address decoder bug
    [65C02_Computer.sch]
2020-01-26 Implemented most simple example with cc65
    [firmware.basic.cfg, firmware.ext.cfg]
2020-01-26 Migrated another program to cc65
    [firmware.basic.cfg, firmware.ext.cfg]
2020-01-26 Migrated first code to cc65
    [firmware.basic.cfg, firmware.ext.cfg]
2020-01-26 Migrated another part of the code to cc65
    [firmware.basic.cfg, firmware.ext.cfg]
2020-01-26 Migrated knight rider to cc65
    [firmware.basic.cfg, firmware.ext.cfg]
2020-01-27 Implemented basic, working ACIA code
    [firmware.basic.cfg, firmware.ext.cfg]
2020-01-27 Fixed ACIA connection issue
    [65C02_Computer.sch]
2020-01-27 Migrated LCD Test code
    [firmware.basic.cfg, firmware.ext.cfg]
2020-01-27 Migrated memory test to cc65
    [firmware.basic.cfg, firmware.ext.cfg]
2020-01-29 First C code implementation
    [firmware.basic.cfg, firmware.ext.cfg]
2020-02-03 Added FT230X chip, moved peripherals to separate sheet
    [6502_IO.sch, 65C02_Computer.sch]
2020-02-03 Minor improvements
    [firmware.basic.cfg, firmware.ext.cfg]
2020-02-03 Added keyboard microcontroller
    [6502_IO.sch]
2020-02-04 Changed implementation of LCD test
    [firmware.basic.cfg, firmware.ext.cfg]
2020-02-04 Migrated rest of the code to new mapping model
    [firmware.basic.cfg, firmware.ext.cfg]
2020-02-04 Migrated C code to new model
    [firmware.basic.cfg, firmware.ext.cfg]
2020-02-05 Reorganized code a bit
    [firmware.basic.cfg, firmware.ext.cfg]
2020-02-05 Removed obsolete code
    [firmware.basic.cfg, firmware.ext.cfg]
2020-02-06 Added sample interrupt code
2020-02-07 Testing 4-bit LCD mode
    [firmware.basic.cfg, firmware.ext.cfg]
2020-02-07 Implemented 4-bit print code
2020-02-10 Added two more lines to system port
    [65C02_Computer.sch]
2020-02-10 Added input IRQ pin, CLK jumper, changed pull-up values
    [65C02_Computer.sch]
2020-02-11 Various updates to schematic
    [6502_IO.sch, 65C02_Computer.kicad_pcb, 65C02_Computer.sch]
2020-02-11 Fixed hardware H/S code
    [handshake_test.ino]
2020-02-13 Further updates to schematic
    [65C02_Computer.kicad_pcb, 65C02_Computer.sch]
2020-02-14 Moved things around PCB
    [65C02_Computer.kicad_pcb]
2020-02-14 Some more tracks added
    [65C02_Computer.kicad_pcb]
2020-02-14 Almost done...
    [65C02_Computer.kicad_pcb]
2020-02-14 All tracks placed on PCB, DRC fine
    [65C02_Computer.kicad_pcb]
2020-02-14 Basic annotations added
    [65C02_Computer.kicad_pcb]
2020-02-14 Moved VIA1
    [65C02_Computer.kicad_pcb]
2020-02-15 Added clock module schematic
    [Clock_module.kicad_pcb, Clock_module.sch]
2020-02-15 Small changes
    [6502_IO.sch, 65C02_Computer.kicad_pcb]
2020-02-15 Reordered PCB components
    [6502_IO.sch, 65C02_Computer.kicad_pcb, 65C02_Computer.sch]
2020-02-17 Redesign in progress
    [6502_IO.sch, 65C02_Computer.kicad_pcb, Clock_module.kicad_pcb, Clock_module.sch]
2020-02-17 PCB RC1
    [6502_IO.sch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]
2020-02-17 PCB RC2 - updated FT230XS footprint
    [6502_IO.sch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]
2020-02-17 Added missing pull-down resistor to clock module
    [Clock_module-B_Cu.gbl, Clock_module-B_Mask.gbs, Clock_module-B_SilkS.gbo, Clock_module-Edge_Cuts.gm1, Clock_module-F_Cu.gtl, Clock_module-F_Mask.gts, Clock_module-F_SilkS.gto, Clock_module.drl]
2020-02-17 PCB RC4 - added longer pads to SSOP chip
    [6502_IO.sch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]
2020-02-17 PCB RC5 - fixed issue with RV1
    [65C02_Computer-B_Cu.gbl, 65C02_Computer-B_Mask.gbs, 65C02_Computer-B_SilkS.gbo, 65C02_Computer-Edge_Cuts.gm1, 65C02_Computer-F_Cu.gtl, 65C02_Computer-F_Mask.gts, 65C02_Computer-F_SilkS.gto, 65C02_Computer.drl]
2020-02-17 Added kicad_pcb-bak files to .gitignore
2020-02-19 Added ferrite bead, got rid of DRC errors, other changes
    [6502_IO.sch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]
2020-02-19 Updated output folder
    [Clock_module.kicad_pcb]
2020-02-19 Improved 65C02 PCB
    [65C02_Computer-B_Cu.gbl, 65C02_Computer-B_Mask.gbs, 65C02_Computer-B_SilkS.gbo, 65C02_Computer-Edge_Cuts.gm1, 65C02_Computer-F_Cu.gtl, 65C02_Computer-F_Mask.gts, 65C02_Computer-F_SilkS.gto, 65C02_Computer.drl]
2020-02-19 PCB RC6
    [Clock_module-B_Cu.gbl, Clock_module-B_Mask.gbs, Clock_module-B_SilkS.gbo, Clock_module-Edge_Cuts.gm1, Clock_module-F_Cu.gtl, Clock_module-F_Mask.gts, Clock_module-F_SilkS.gto, Clock_module.drl]
2020-02-19 Removed old interrupt test code
2020-02-22 Increased RESET pull-up resistor value
    [65C02_Computer.sch]
2020-02-22 Added AVR ISP interface
    [6502_IO.sch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]
2020-02-22 Changed AVR ISP port to 10-pin
    [6502_IO.sch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]
2020-02-23 Added one more Cap for stable power
    [6502_IO.sch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]
2020-02-23 PCB RC7
    [65C02_Computer-B_Cu.gbl, 65C02_Computer-B_Mask.gbs, 65C02_Computer-B_SilkS.gbo, 65C02_Computer-Edge_Cuts.gm1, 65C02_Computer-F_Cu.gtl, 65C02_Computer-F_Mask.gts, 65C02_Computer-F_SilkS.gto, 65C02_Computer.drl]
2020-02-23 PCB RC8
    [65C02_Computer-B_Cu.gbl, 65C02_Computer-B_Mask.gbs, 65C02_Computer-B_SilkS.gbo, 65C02_Computer-Edge_Cuts.gm1, 65C02_Computer-F_Cu.gtl, 65C02_Computer-F_Mask.gts, 65C02_Computer-F_SilkS.gto, 65C02_Computer.drl]
2020-02-23 PCB RC9 - replaced potentiometers
    [6502_IO.sch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]
2020-02-23 PCB RC10 - moved connector label
    [65C02_Computer-B_Cu.gbl, 65C02_Computer-B_Mask.gbs, 65C02_Computer-B_SilkS.gbo, 65C02_Computer-Edge_Cuts.gm1, 65C02_Computer-F_Cu.gtl, 65C02_Computer-F_Mask.gts, 65C02_Computer-F_SilkS.gto, 65C02_Computer.drl]
2020-03-02 Fixed issue with overwriting blink LED status
2020-03-07 Moved support for blink LED to common code
2020-03-10 Added BOM for computer and clock
2020-03-11 Corrected typo in RV1 of clock module BOM
2020-03-12 Updated schematic to match changes to BOM
    [Clock_module.kicad_pcb, Clock_module.sch]
2020-03-18 Reapplied stash, corrected makefile
    [keyboard_4313.ino, keyboard_mega.ino]
2020-03-18 Updated keyboard controller to fix extra messages
    [keyboard_4313.ino]
2020-03-19 Initial implementation of X-MODEM protocol
    [firmware.basic.cfg, firmware.ext.cfg]
2020-03-19 Started implementation of syscall vectors
    [firmware.basic.cfg, firmware.ext.cfg]
2020-03-20 Major build process refactoring
    [firmware.basic.cfg, firmware.ext.cfg, load.cfg]
2020-03-20 Moved things around even more
    [firmware.basic.cfg, firmware.ext.cfg, load.cfg]
2020-03-21 Clarify 1/4w resistors for proper fitment on board
2020-03-21 PDF versions of the schematics
2020-03-22 Updated basic programs to use VIA2
    [firmware.basic.cfg, firmware.ext.cfg]
2020-03-23 Another large refactoring
    [firmware.basic.cfg, firmware.ext.cfg, load.cfg]
2020-03-23 Soldering section added
2020-03-26 Added sample alternate loadable module approach
    [load.cfg]
2020-03-31 Finally sorted out SYS RAM mapping issue
    [firmware.basic.cfg, firmware.ext.cfg, load.cfg]
2020-03-31 Updated to reflect current build process
2020-04-01 Fixed keyboard status defect, added support for CTRL+X
    [keyboard_4313.ino]
2020-04-08 Corrected issue #34
    Corrected pot value for clock frequency regulator
2020-04-10 Initial implementation - not working
    [load.cfg]
2020-04-15 Resolved #23
    [firmware.basic.cfg, firmware.ext.cfg, load.cfg]
2020-04-18 Initial purchase details for BOM
2020-04-21 Correct part number for 28-pin socket
2020-04-21 Redesigned zeropage memory handling
    [firmware.basic.cfg, firmware.ext.cfg, load.cfg]
2020-05-03 Program structure works!
    [load.cfg]
2020-05-06 Improved switch/case macro
2020-06-24 Added system information command
    [firmware.basic.cfg, firmware.ext.cfg, load.cfg]
2020-07-01 Initial import of Microsoft BASIC archive
    [applesoft.cfg, cbmbasic1.cfg, cbmbasic2.cfg, kb9.cfg, kbdbasic.cfg, microtan.cfg, osi.cfg]
2020-07-01 Integrated into build process
    [firmware.basic.cfg, firmware.ext.cfg]
2020-07-01 Fixed compilation warnings
    [firmware.basic.cfg, firmware.ext.cfg]
2020-07-02 Working loadable module with some improvements
    [load.cfg]
2020-07-02 Added file to track necessary changes
2020-07-02 Small fixes and tweaks
    [firmware.basic.cfg, firmware.ext.cfg, load.cfg]
2020-07-03 Removed self-modifying code and reduced ZP footprint
2020-07-07 Hello world example for UART
2020-07-08 Fixed port inputs (they do work now)
    [main.c]
2020-07-10 Added simple T! timer program
2020-07-12 First implementation, not working (Serial library)
    [6502-mega-debugger.ino]
2020-07-12 Using direct UART communication
2020-07-18 Added XLSX files with 6502 BOM
    [DB6502BOM.xlsx, DB6502BOMSortedQty.xlsx]
2020-07-20 First version of DUART schematic
    Initial revision (draft)
    [DUART_expansion.kicad_pcb, DUART_expansion.sch]
2020-07-21 Initial working version (still unstable!)
    [DUART_expansion.sch]
2020-07-23 Replaced can with crystal, removed unused connections
    [DUART_expansion.sch]
2020-08-13 Initial version of the ATMega644-based in-circuit programmer
    [ATMega_Programmer.kicad_pcb, ATMega_Programmer.sch]
2020-08-14 Updates to schematic
    [ATMega_Programmer.sch]
2020-08-17 Added single gate ICs for clock selection and automatic SR reset
    [ATMega_Programmer.sch]
2020-08-18 Changed 74LVC1G126 to 74LVC1G125 for low-active OE
    [ATMega_Programmer.sch]
2020-08-24 Fixed issue with UART initialization
    [main.c, uart.c, uart.h]
2020-08-27 Added printable chars output to dump operation
2020-08-30 Solved issues with lrzsz on MacOS
    [uart.c, xmodem.c]
2020-09-04 Finally figured out timers in AVR...
2020-09-14 Started working on DB6502 v2 schematic
    [DB6502_v002.kicad_pcb, DB6502_v002.sch]
